Bettapro/Weather-Station-V3/models/readme.md

## STL File
Here the stl you have to print, you can use resin or FDM 3D printer.

*NOTE: Original stl come from Michael Klements work*
