Bettapro/Weather-Station-V3/docs/ESP32.md

## ESP32

# Sensor wiring (ESP32 bare module + breakout board)

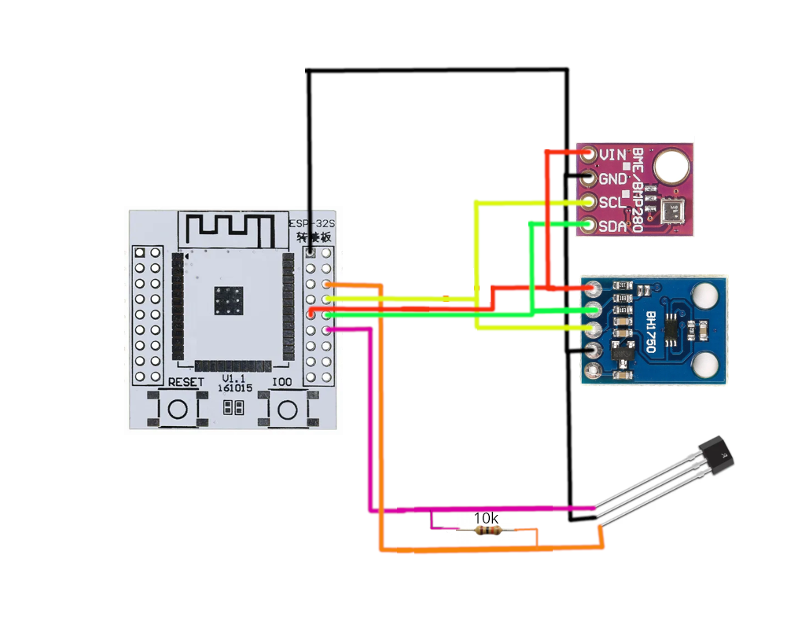
[picture p2: images/weather station esp32 bare.png]


# Sensor wiring (ESP32 D1 mini)

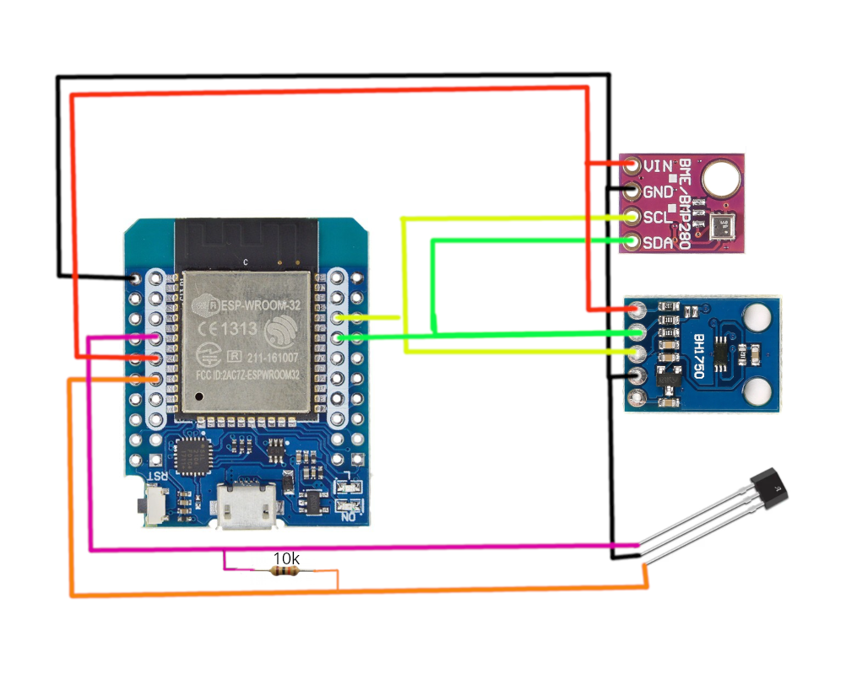
[picture p3: images/weather station esp32.png]
