Bettapro/Weather-Station-V3/docs/ESP8266.md

## ESP8266

# Sensor wiring (ESP8266 D1 mini)

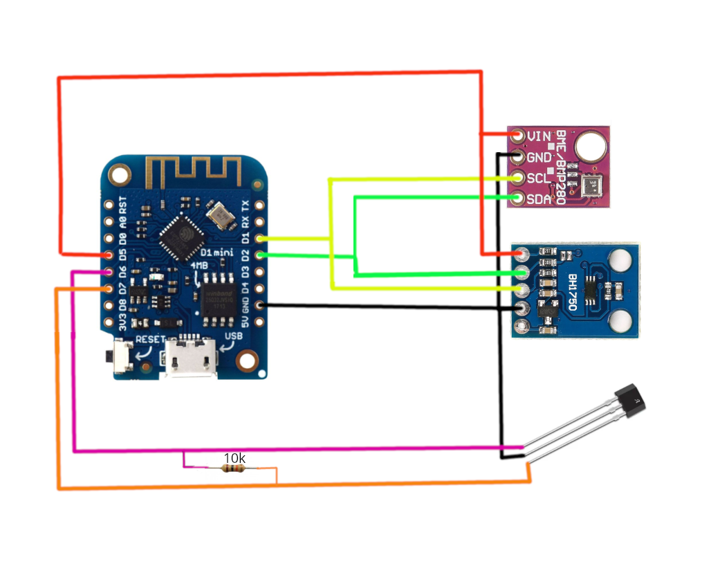
[picture p4: images/weather station esp8266.png]
