Bettapro/Weather-Station-V3/models/Anaemometer.stl

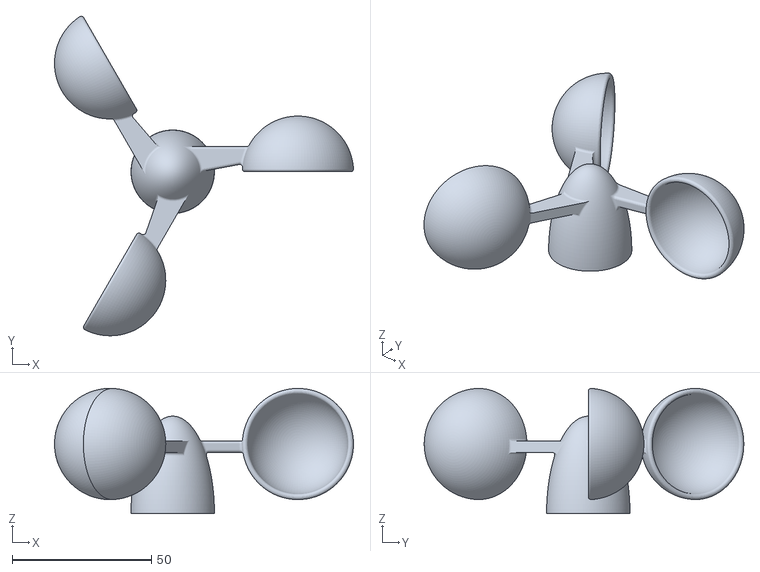
[picture p5: CAD file, 2025-10-01]
models/Anaemometer.stl
107.5 x 114.9 x 45.0
