Bettapro/Weather-Station-V3/models/Sensor Holder.stl

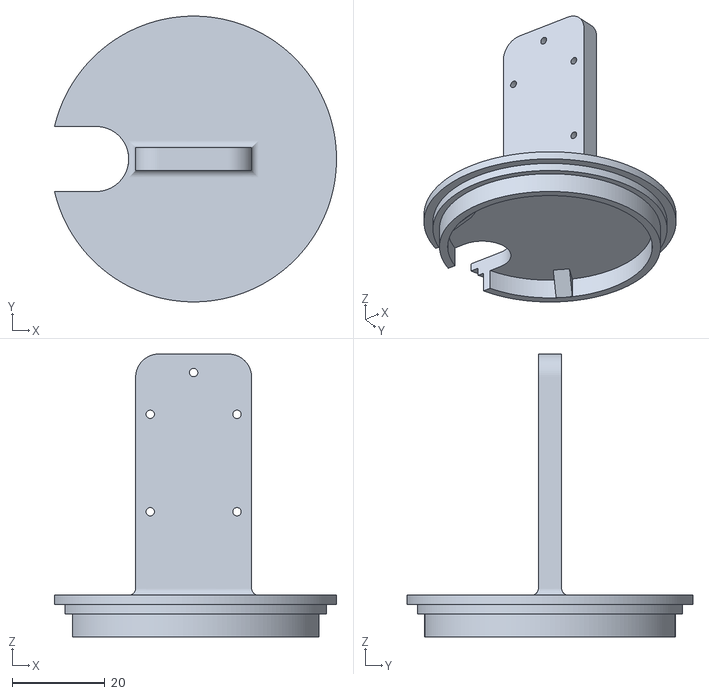
[picture p6: CAD file, 2025-10-01]
models/Sensor Holder.stl
60.8 x 61.6 x 61.0
