Bettapro/Weather-Station-V3/models/Base.stl

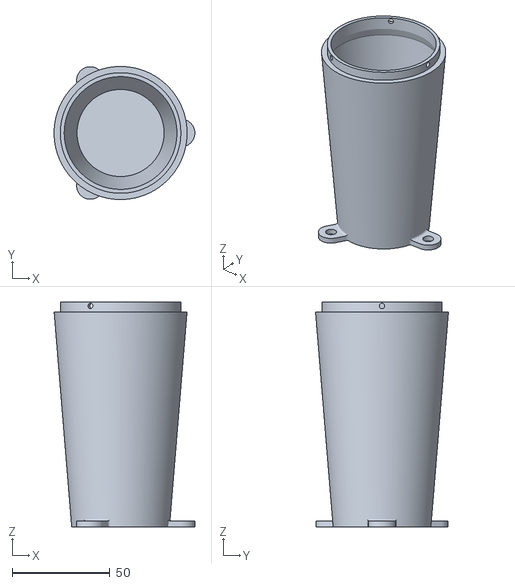
[picture p7: CAD file, 2025-10-01]
models/Base.stl
72.0 x 68.0 x 115.0
