Bettapro/Weather-Station-V3/WeatherStation/WeatherStation.ino

/**
 * Weather station V3 [https://github.com/Bettapro/Weather-Station-V3]
 * Copyright (c) 2022 Alberto Bettin
 *
 * Based on the work of Michael Klements from "The DIY Life"
 *
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
 */

#include <vector>

#include "src/incl/include_all_core.h"
#include "src/incl/include_all_feature.h"
#include "src/incl/include_all_lib.h"

#define uS_TO_S_FACTOR 1000000ULL  // Conversion factor for micro seconds to seconds

DoubleResetDetector* drd;
std::vector<Sensor*> sensors;

bool attemptWifiConnection(const environrmentData* envData, unsigned long timeoutLength = 5000) {
    if (strlen(envData->wifiSSID) <= 0) {
        return false;
    }

    IPAddress ip;
    IPAddress gateway;
    IPAddress subnet;
    IPAddress dns1;
    IPAddress dns2;

    WiFi.persistent(false);
    WiFi.enableSTA(true);

    if (strlen(envData->wifiIp)) {
        ip.fromString(envData->wifiIp);

        if (strlen(envData->wifiGateway)) {
            gateway.fromString(envData->wifiGateway);
        }
        if (strlen(envData->wifiSubnet)) {
            subnet.fromString(envData->wifiSubnet);
        }
        if (strlen(envData->wifiDns1)) {
            dns1.fromString(envData->wifiDns1);
        }
        if (strlen(envData->wifiDns2)) {
            dns2.fromString(envData->wifiDns2);
        }
        WiFi.config(ip, gateway, subnet, dns1, dns2);
    }

    uint8_t wifiStatus = WL_DISCONNECTED;

    WiFi.begin(Environment::getData()->wifiSSID, Environment::getData()->wifiPassword);
    wifiStatus = WiFi.waitForConnectResult(timeoutLength);
    // if (wifiStatus == WL_DISCONNECTED) {
    //    WiFi.reconnect();
    //    wifiStatus = WiFi.waitForConnectResult(timeoutLength);
    //}

    return wifiStatus == WL_CONNECTED;
}

int8_t getSleepMult(float batterySOC) {
#ifdef USE_BATTERY_SOC
    if (batterySOC < BATTERY_SOC_MIN_SOC) {
        return -6;
    }
    if (batterySOC < BATTERY_SOC_MIN_THROTTLE_SOC) {
        return BATTERY_SOC_MIN_THROTTLE_SOC - batterySOC < batterySOC - BATTERY_SOC_MIN_SOC ? 2 : 4;
    }
#endif
    return 1;
}

void stopAllSensors() {
    for (const auto& sensor : sensors) {
        sensor->stop();
    }
#ifdef ESP32
    Wire.end();
#endif
}

void terminateAndExit(uint8_t sleepMult) {
    stopAllSensors();

    const environrmentData* envData = Environment::getData();
    drd->stop();
    Serial.println("Going to sleep now");
    Serial.flush();

    ESP.deepSleep(envData->updateInterval * uS_TO_S_FACTOR * sleepMult);  // Enter sleep mode
}

void setup()  // Setup function - only function that is run in deep sleep mode
{
    // Bring down the WiFi connection at boot
    WiFi.mode(WIFI_OFF);
#ifdef ESP8266
    WiFi.forceSleepBegin();
#endif
#ifdef ESP32
    btStop();
#endif
    delay(1);

    bool isDeepSleepWakeup = false;
#ifdef ESP8266
    if (ESP.getResetInfoPtr()->reason == REASON_DEEP_SLEEP_AWAKE) {
        isDeepSleepWakeup = true;
    }
#elif defined(ESP32)
    if (esp_reset_reason() == ESP_RST_DEEPSLEEP) {
        isDeepSleepWakeup = true;
    }
#endif

    int8_t sleepMult = 1;
    Serial.begin(SERIAL_DEBUG_BAUDRATE);
    Environment::loadEnvData();
    const environrmentData* envData = Environment::getData();

    drd = new DoubleResetDetector(2, 0);

    if (drd->detectDoubleReset() && !isDeepSleepWakeup) {
        drd->stop();
        Serial.println("Double Reset Detected");

        attemptWifiConnection(envData);

        WifiManagerWB::startWifiConfigurationAP(true);
        ESP.restart();
    }

#ifdef USE_BATTERY_SOC
    Sensor_BatterySOC battery(BATTERY_SOC_MAX_VOLTAGE, BATTERY_SOC_MIN_VOLTAGE, BATTERY_SOC_ADC_PIN);
    sensors.push_back(&battery);
#endif

#ifdef USE_ANALOG_LIGHT_SENSOR
    Sensor_AnalogLightSensor lightSensor(ANALOG_LIGHT_SENSOR_ADC_PIN, ANALOG_LIGHT_SENSOR_POWER_PIN);
    sensors.push_back(&lightSensor);
#endif

#ifdef USE_BH1750
    Sensor_BH1750 bh1750(BH1750_I2C_ADDRESS, BH1750_POWER_PIN);
    sensors.push_back(&bh1750);
#endif

#ifdef USE_SHT31
    Sensor_SHT31 sht31(SHT31_I2C_ADDRESS, SHT31_POWER_PIN);
    sensors.push_back(&sht31);
#endif

#ifdef USE_BME280
    Sensor_BME280 bme280(BME280_I2C_ADDRESS, BME280_POWER_PIN);
    sensors.push_back(&bme280);
#endif

#ifdef USE_DIGITAL_ANEMOMETER
    Sensor_DigitalAnemometer anemometer(DIGITAL_ANEMOMETER_SIGNAL_PIN, DIGITAL_ANEMOMETER_POWER_PIN);
    sensors.push_back(&anemometer);
#endif

#ifdef USE_THINGSPEAK
    Sync_ThingSpeak syncTS(envData->thingSpeakApiKey, envData->thingSpeakChannel);
#endif
#ifdef USE_MQTT_HOME_ASSISTANT
    Sync_HA syncHa(envData->mqttServerHostname, envData->mqttUsername, envData->mqttPassword, envData->mqttClientId, envData->mqttHADeviceName);
#endif

    for (const auto& sensor : sensors) {
        sensor->start();
    }

    // giving some extra time to all sensors to start a setup
    delay(500);
    drd->loop();
    Wire.begin();
    for (const auto& sensor : sensors) {
        if (!sensor->setup()) {
            Serial.print("Error while setting up ");
            Serial.println(sensor->getName());
        }
    }

    float cValue;
    for (const auto& sensor : sensors) {
        Serial.print("Reading from ");
        Serial.println(sensor->getName());

        sensor->readAll();
        for (uint8_t rdi = 0; rdi < RD_COUNT; rdi++) {
            ReadingType rd = (ReadingType)rdi;
            if (sensor->isOk() && sensor->has(rd)) {
                cValue = sensor->get(rd);
                switch (rd) {
                    case RD_BATTERY_SOC:
                        sleepMult = getSleepMult(cValue);
                        if (sleepMult < 0) {
                            Serial.println("Battery SOC is below the min. percentage, SLEEP NOW");
                            terminateAndExit(-sleepMult);
                        }
                        Serial.print("Battery SOC");
                        break;
                    case RD_HUMIDITY:
                        Serial.print("Humidity");
                        break;
                    case RD_LIGHT:
                        Serial.print("Light intensity");
                        break;
                    case RD_PRESSURE:
                        Serial.print("Pressure");
                        break;
                    case RD_TEMPERATURE:
                        Serial.print("Temperature");
                        break;
                    case RD_WIND_SPEED:
                        Serial.print("Wind speed");
                        break;
                    default:
                        Serial.print("????");
                        break;
                }
                Serial.print(": ");
                Serial.println(cValue);
#ifdef USE_MQTT_HOME_ASSISTANT
                syncHa.load(rd, cValue);
#endif
#ifdef USE_THINGSPEAK
                syncTS.load(rd, cValue);
#endif
            }
        }
        drd->loop();
    }

    stopAllSensors();

    if (attemptWifiConnection(envData, 30000)) {
        Serial.println();
        Serial.println("WiFi connected");
#ifdef USE_THINGSPEAK
        syncTS.setup();
        uint8_t syncTSResult = syncTS.flush();
        if (syncTSResult != 0) {
            Serial.printf("Sync ERROR with ThingSpeak [%d]", syncTSResult);
            Serial.println();
        }
        syncTS.stop();
#endif
#ifdef USE_MQTT_HOME_ASSISTANT
        syncHa.setup(isDeepSleepWakeup);
        uint8_t syncHaResult = syncHa.flush();
        if (syncHaResult != 0) {
            Serial.printf("Sync ERROR with HA [%d]", syncHaResult);
            Serial.println();
        } else {
            Serial.println("Sync OK with HA ");
        }
        syncHa.stop();
#endif
        // sync completed -> disconnect for wifi
        delay(1);
        Serial.println("Wifi disconnected");
        WiFi.disconnect(true);
        delay(1);
    } else {
        Serial.println();
        Serial.printf("WiFi connection failed [%d]", WiFi.status());
        Serial.println();
    }

    terminateAndExit(sleepMult);
}

void loop()  // Loop function - unused
{
}
