Bettapro/Weather-Station-V3/WeatherStation/config.h

/**
 * Weather station V3 [https://github.com/Bettapro/Weather-Station-V3]
 * Copyright (c) 2022 Alberto Bettin
 *
 * Based on the work of Michael Klements from "The DIY Life"
 *
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
 */

#pragma once

#define SERIAL_DEBUG_BAUDRATE 115200


/*
 * WIFI

 * Fill with you wifi auth. data
 */
// your wifi SSID
#define WIFI_SSID             "-your-wifi-"
// your wifi PASSWORD
#define WIFI_PASS             "-your-password-"
// your wifi IP ADDRESS
#define WIFI_IP_ADDRESS       ""
// your wifi GATEWAY
#define WIFI_GATEWAY          ""
// your wifi SUBNET
#define WIFI_SUBNET           ""
// your wifi DNS1
#define WIFI_DNS1             ""
// your wifi DNS2
#define WIFI_DNS2             ""

#define WIFI_AP_CONFIGURATION_HOSTNAME "WeatherAP"
#define WIFI_AP_CONFIGURATION_PASSWORD "admin1234"

#define DEEP_SLEEP_FOR_SEC 500

//#define USE_ANALOG_LIGHT_SENSOR
#ifdef USE_ANALOG_LIGHT_SENSOR
  //#define ANALOG_LIGHT_SENSOR_ADC_PIN 36

  //#define ANALOG_LIGHT_SENSOR_POWER_PIN 19
#endif

#define USE_BH1750
#ifdef USE_BH1750
  #define BH1750_I2C_ADDRESS 0x23

  //#define BH1750_POWER_PIN 19
#endif

#define USE_BME280
#ifdef USE_BME280
  #define BME280_I2C_ADDRESS 0x76

  //#define USE_BME280_TEMPERATURE
  //#define USE_BME280_HUMIDITY
  #define USE_BME280_PRESSURE

  //#define BME280_POWER_PIN 19
#endif

#define USE_SHT31
#ifdef USE_SHT31
  #define SHT31_I2C_ADDRESS 0x44

  #define USE_SHT31_TEMPERATURE
  #define USE_SHT31_HUMIDITY

  //#define SHT31_POWER_PIN 19
#endif

#define USE_DIGITAL_ANEMOMETER
#ifdef USE_DIGITAL_ANEMOMETER
  //#define DIGITAL_ANEMOMETER_POWER_PIN 18

  //#define DIGITAL_ANEMOMETER_SIGNAL_PIN 23
#endif

#define USE_BATTERY_SOC
#ifdef USE_BATTERY_SOC
    //#define BATTERY_SOC_ADC_PIN 34
    #define BATTERY_SOC_MAX_VOLTAGE 4.42

    #define BATTERY_SOC_MIN_VOLTAGE 3.3

    #define BATTERY_SOC_MIN_THROTTLE_SOC 50

    #define BATTERY_SOC_MIN_SOC 20
#endif

//#define USE_THINGSPEAK
#if defined(USE_THINGSPEAK)
  #define THINGSPEAK_CHANNEL 1

  #define THINGSPEAK_API_KEY "--api-key---"
#endif

#define USE_MQTT
#if defined (USE_MQTT)
  //address of mqtt server (specify the hostname or the ip address eg: IPAddress(192, 168, 1, 78) )
  #define MQTT_SERVER "127.0.0.1"
  // port number of the mqtt server (eg: 1883)
  #define MQTT_PORT 1883
  // username to use 
  #define MQTT_USERNAME "user"
  // password to use in combination with MQTT_USERNAME
  #define MQTT_PASSWORD "password"
  // client id
  #define MQTT_CLIENT_ID "weatherstation1"

  #define USE_MQTT_HOME_ASSISTANT
  #ifdef USE_MQTT_HOME_ASSISTANT
    #define MQTT_HOME_ASSISTANT_DEVICE_NAME "Weather-station01"
  #endif
 #endif
