Bettapro/Weather-Station-V3/WeatherStation/src/sensors/impl/Sensor_BME280.h

/**
 * Weather station V3 [https://github.com/Bettapro/Weather-Station-V3]
 * Copyright (c) 2022 Alberto Bettin
 *
 * Based on the work of Michael Klements from "The DIY Life"
 *
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
 */

#ifndef SENSOR_BME280_H
#define SENSOR_BME280_H

#include "../Sensor.h"
#include "../SensorAvgRead.h"

#include <Adafruit_BME280.h>

#define SAMPLE_COUNT 3
#define SAMPLE_TIME 100

class Sensor_BME280 : public Sensor
{
public:
    Sensor_BME280(byte addr, int8_t pin = -1)
    {
        this->bme = new Adafruit_BME280();
        this->pin = pin;
        this->address = addr;
    }
    const char *getName()
    {
        return "BME280";
    }
    void start()
    {
        if (this->pin >= 0)
        {
            digitalWrite(this->pin, HIGH);
        }
    };
    bool setup()
    {
        return this->ok = this->bme->begin(address);
    };
    void readAll()
    {
#ifdef USE_BME280_PRESSURE
        SensorAvgRead pressureAvg;
#endif
#ifdef USE_BME280_HUMIDITY
        SensorAvgRead humidityAvg;
#endif
#ifdef USE_BME280_TEMPERATURE
        SensorAvgRead temperatureAvg;
#endif
        for (uint8_t sampleCount = 0; sampleCount < SAMPLE_COUNT; sampleCount++)
        {
            if(sampleCount > 0){
                delay(SAMPLE_TIME);
            }
#ifdef USE_BME280_TEMPERATURE
            temperatureAvg.accumulate(bme->readTemperature(), [](float v)
                                      { return v >= -40 && v <= 85; });
#endif
#ifdef USE_BME280_HUMIDITY
            humidityAvg.accumulate(bme->readHumidity(), [](float v)
                                   { return v >= 0 && v <= 100; });
#endif
#ifdef USE_BME280_PRESSURE
            pressureAvg.accumulate(bme->readPressure() / 100.0, [](float v)
                                   { return v >= 300 && v <= 1100; });
#endif
            
        }
#ifdef USE_BME280_PRESSURE
        this->pressure = pressureAvg.get(-1);
#endif
#ifdef USE_BME280_HUMIDITY
        this->humidity = humidityAvg.get(-1);
#endif
#ifdef USE_BME280_TEMPERATURE
        this->temperature = temperatureAvg.get(-999);
#endif
    }

    void stop()
    {
        if (this->pin >= 0)
        {
            pinMode(this->pin, OUTPUT);
            digitalWrite(this->pin, LOW);
        }
    }

    float get(ReadingType what)
    {
        if (this->has(what))
        {
            switch (what)
            {
#ifdef USE_BME280_TEMPERATURE
            case RD_TEMPERATURE:
                return this->temperature;
#endif
#ifdef USE_BME280_PRESSURE
            case RD_PRESSURE:
                return this->pressure;
#endif
#ifdef USE_BME280_HUMIDITY
            case RD_HUMIDITY:
                return this->humidity;
#endif
            }
        }
        return 0;
    }

    bool has(ReadingType what)
    {
        switch (what)
        {
#ifdef USE_BME280_TEMPERATURE
        case RD_TEMPERATURE:
            return this->temperature >= -40;
#endif
#ifdef USE_BME280_PRESSURE
        case RD_PRESSURE:
            return this->pressure >= 0;
#endif
#ifdef USE_BME280_HUMIDITY
        case RD_HUMIDITY:
            return this->humidity >= 0;
#endif
        }
        return false;
    }

private:
    Adafruit_BME280 *bme;
    byte address;
    int8_t pin;
#ifdef USE_BME280_PRESSURE
    float pressure;
#endif
#ifdef USE_BME280_HUMIDITY
    float humidity;
    #endif
#ifdef USE_BME280_TEMPERATURE
    float temperature;
#endif
};

#endif
