Bettapro/Weather-Station-V3/(commit log)

2022-04-27 Mixed improvements and fixes
    [WeatherStation.ino, config.h]
2022-05-12 Mixed fixes and improvements
    [Sensor_BatterySOC.h, WeatherStation.ino, config.h]
2022-12-11 arduino-home-assistant 2.0.0
2022-12-11 arduino-esp32 2.0.5
2022-12-12 Minor bug fixes and improvements
    [Sensor_BH1750.h, Sensor_BME280.h, Sensor_BatterySOC.h, WeatherStation.ino, config.h]
2022-12-12 Add further battery soc preserve check
2025-10-01 FIxes and improvements
    [Anaemometer.stl, Base.stl, Sensor Holder.stl]
2025-10-02 Update Sync_HA.h
    Add UOM in wind speed sensor for HASync
2026-02-18 Minor fixes and code cleanup
    [Environment.cpp, Environment.h, config.h]
2026-06-29 Fix negative battery multiplier
    [WeatherStation.ino]
